exploratec-udd/TornamesaEscaner/README.md

# Manual de usuario para tornamesa de escáner 3D

El Tornamesa de escáner 3D de ExploraTec es una herramienta de licencia abierta de apoyo a la hora de utilizar cualquier tipo de escáner 3d, facilitando el proceso de escanear objetos al rotarlos por el usuario. Se controla a través de una página web alojada en una red local de WiFi

Tornamesa_Render

## Componentes:

### Electrónica:

- #### ESP-32 Dev kit

  El cerebro de la herramienta, utilizado para controlar señales al motor, alojar la página web y crear la red local.

- #### Motor Stepper Bipolar Kysan 1124090 Nema 17

  La fuerza del dispositivo, al ser un Motor Stepper nos permite movimientos controlados y precisos.

- #### Módulo Shield para driver A4988 y driver

  Quien facilita el control de el Motor Stepper, permitirndo además la alimentación del mismo.

- #### Fuente de poder de 9V
  Necesaria pala la alimentación del motor Stepper a través del Modulo Shield

- #### Regulador de voltaje lm2596 dc-dc hw 411 Step Down 

   Quien permite tener una fuente de poder para el dispositivo, al poder usar la fuente de mayor voltaje del motor para poder alimentar a la ESP 32.

 - #### Sensor Hall magnético KY-003

    Para determinar donde se encuentra la rotación del motor y calibración

 |<!-- -->|<!-- -->|
 |:---:|:---:|
 |ESP-32| Motor Stepper|
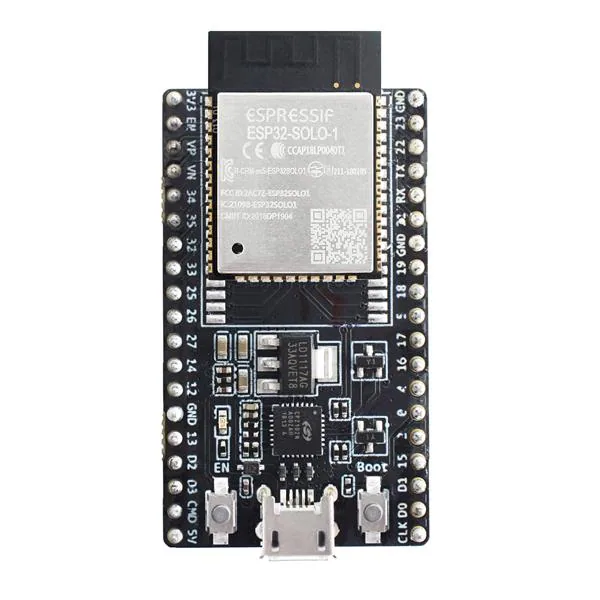
[picture p1: imagenes2/ESP32-DevKit.jpg]
ESP32
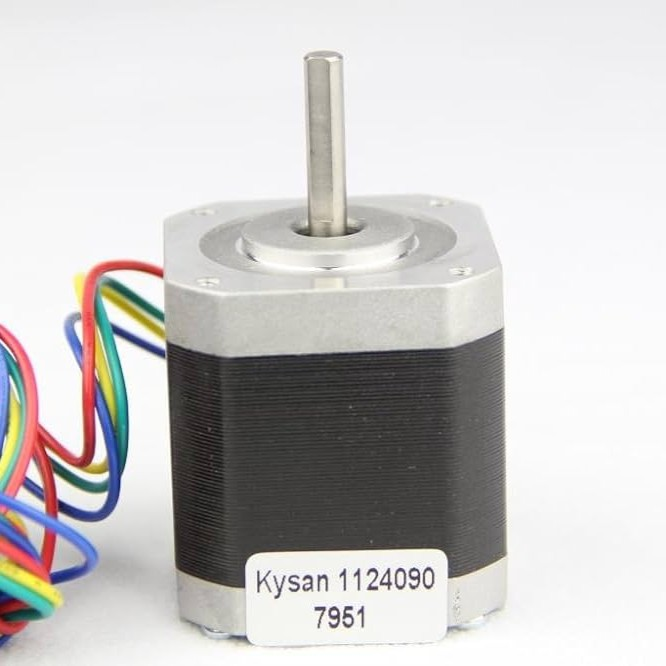
[picture p2: imagenes2/kysan_1124090.jpg]
Kysan 1124090
 |||
 |Módulo Shield|A4988|
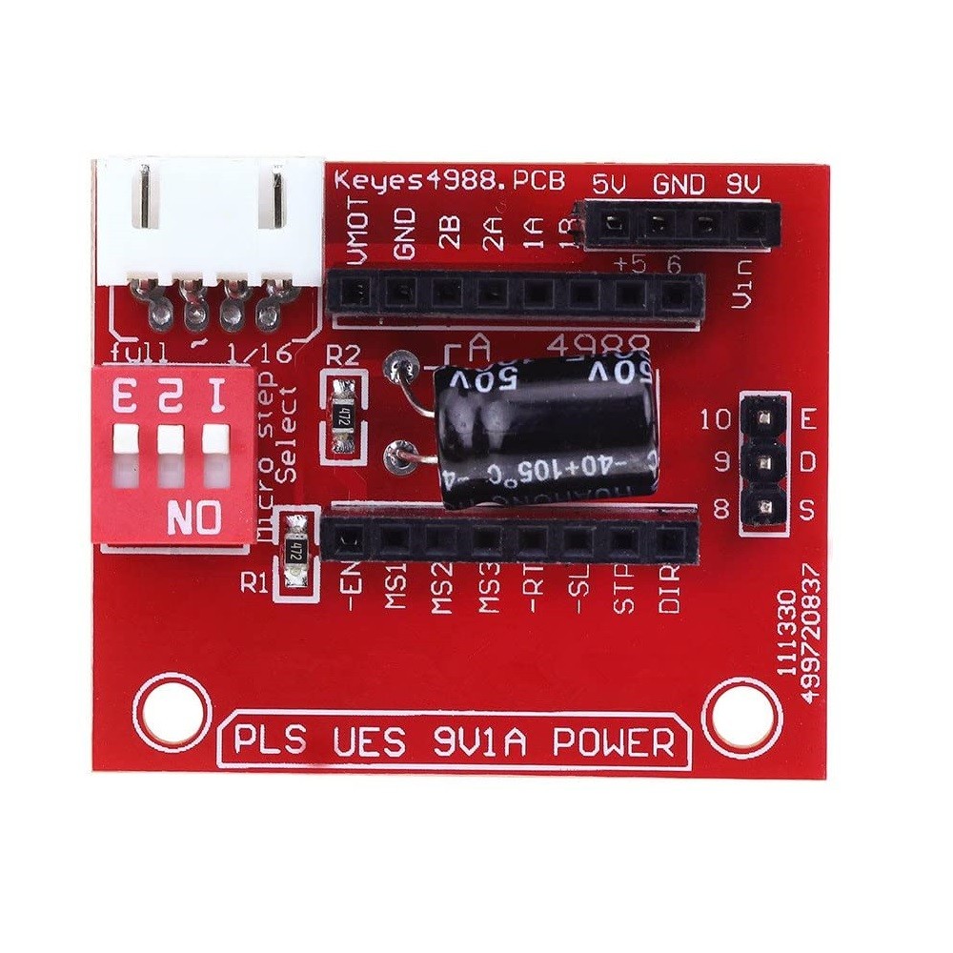
[picture p3: imagenes2/Shield.jpg]
Módulo Shield
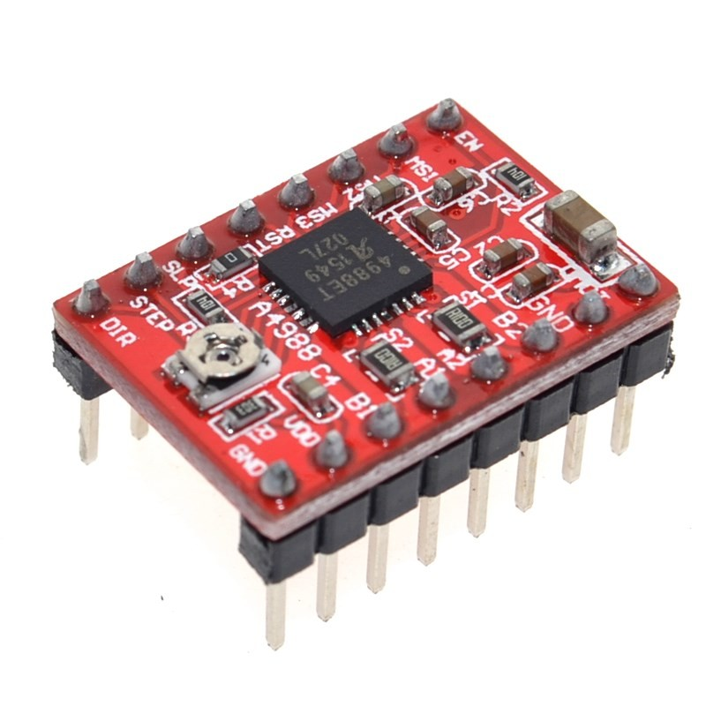
[picture p4: imagenes2/A4988.jpg]
A4988
 |||
 |Fuente de poder|Regulador de voltaje LM2596|
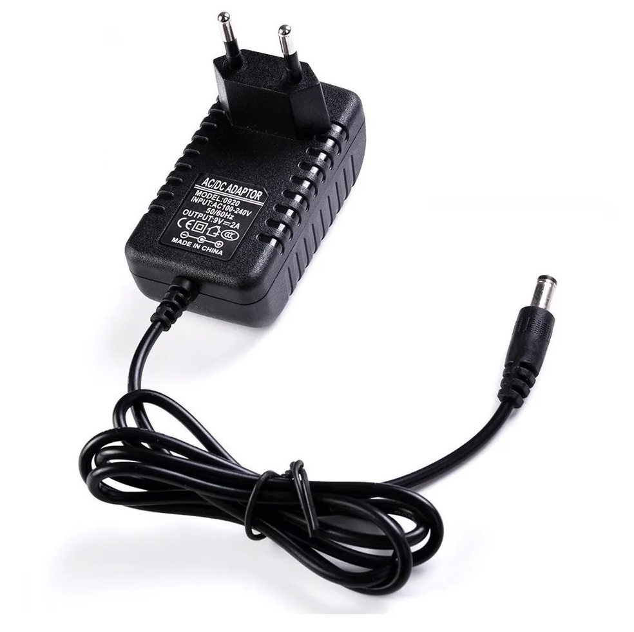
[picture p5: imagenes2/Transformador_de_Corriente.jpg]
Fuente de poder 9V
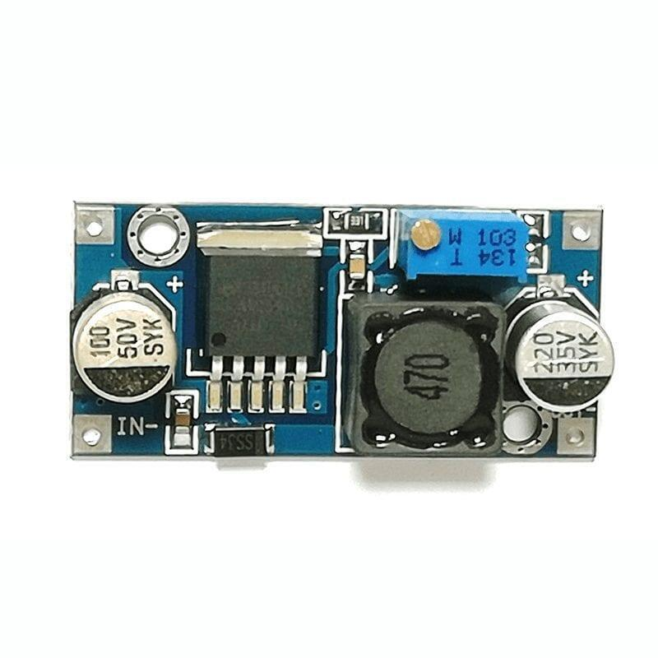
[picture p6: imagenes2/LM2596_Regulador_Step_Down.jpg]
lm2596 dc-dc hw 411 Step Down
 |||
 |Sensor Hall magnético KY-003|
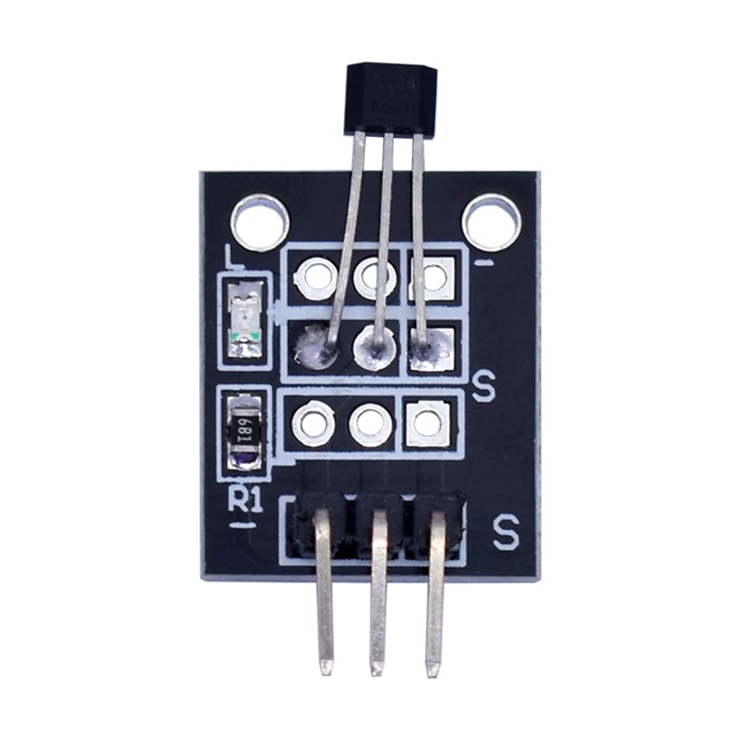
[picture p7: imagenes2/Hall.jpg]
Hall magnético KY-003
 ||
### Hardware:

- #### Componentes Impresos del cuerpo de la mesa

  Las piezas que conforman la estructura de este dispositivo

- #### Pernos e insertos M3

  Encargados de sostener los componentes impresos del Tornamesa

- #### Imán de Neodimio circular 10x3mm

  Necesario para la calibración del dispositivo, es censado por el sensor Hall.  

- #### Rodamiento NSK 6205 C3 ( 25mm x 52mm x 15mm )
  
  Usadas para alivianar el roce y sostener la base de giro

- #### Canicas de 10mm
  
  Usadas para alivianar el roce y equilibrar la superficie de la mesa

- #### Superficie circular (Mínimo 12 Cm)

  Superficie de la mesa donde se colocan los objetos que se deseen escanear, material a elección del usuario.

### Software:

- #### Arduino IDE

  Un entorno de desarrollo integrado que nos permite programar y actualizar el cerebro del sistema.

 - #### Navegador Web

  El dispositivo al ser controlado por una página web local es necesario un navegador para utilizarlo.

 |Arduino IDE|Navegador Web|
 |:---:|:---:|
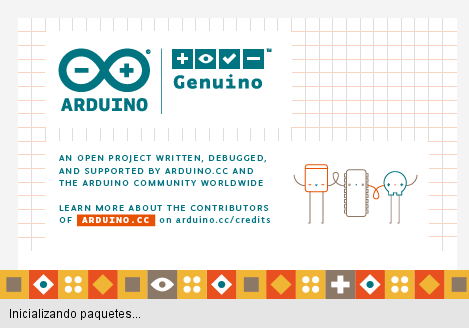
[picture p8: imagenes2/Arduino_IDE.png]
Arduino IDE
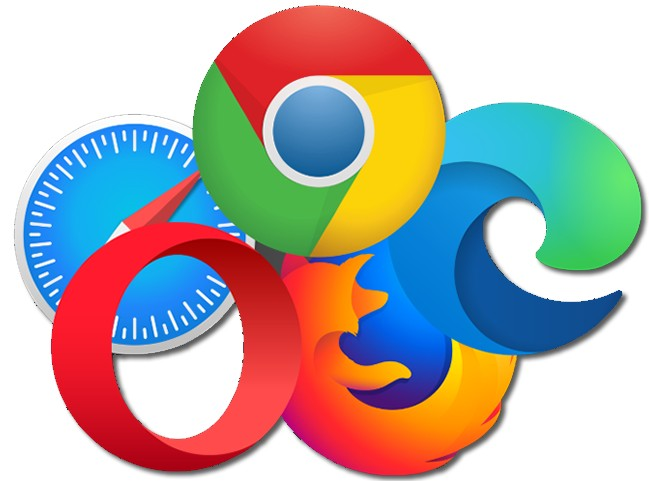
[picture p9: imagenes2/Navegadores.jpg]
Navegadores Web
|||

## Vista explosionada:
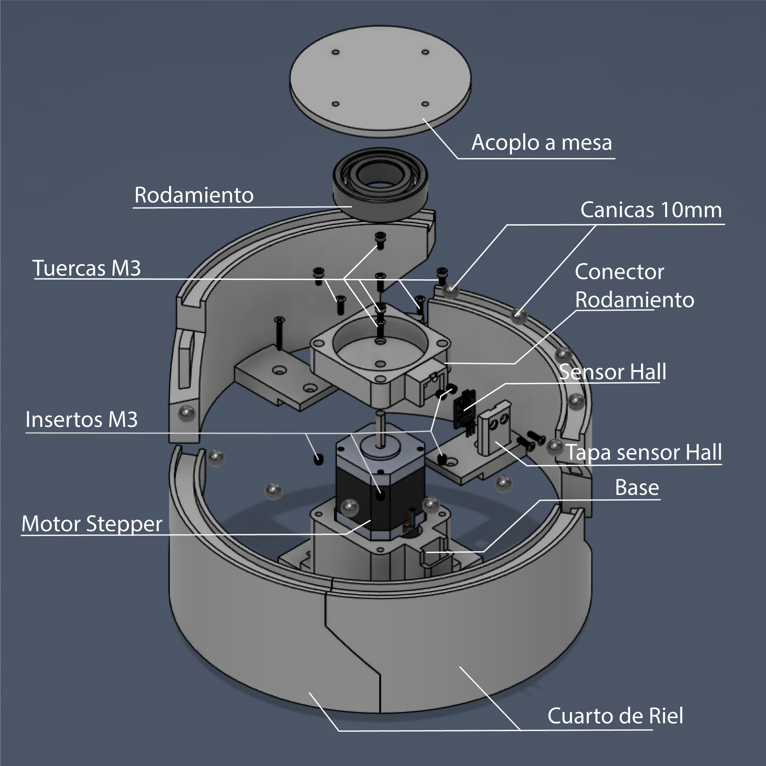
[picture p10: imagenes2/Plano_vista_explosiva.png]
Plano de vista Explosiva del tornamesa


## Instrucciones de uso:

### Encendido

Al encender el dispositivo este como primer paso iniciará su calibración, girará en sentido antihorario para encontrar su punto de inicio:

GifInicio

### Conección y página web

Por defecto, el nombre de la red que debes conectarte para controlar el tornamesa es "ExploraTec Plataforma de Escaner" la cual es una red que permite **hasta 1 usuario por sesion**. La contraseña por defecto es **"12345678"** para acceder a esta y si es accedida a través del telefono celular es posible que pregunte si deseas mantenerte en la red debido a que, al ser una red local, no posee conección al internet.
|<!-- -->|<!-- -->|
|:---:|:---:|
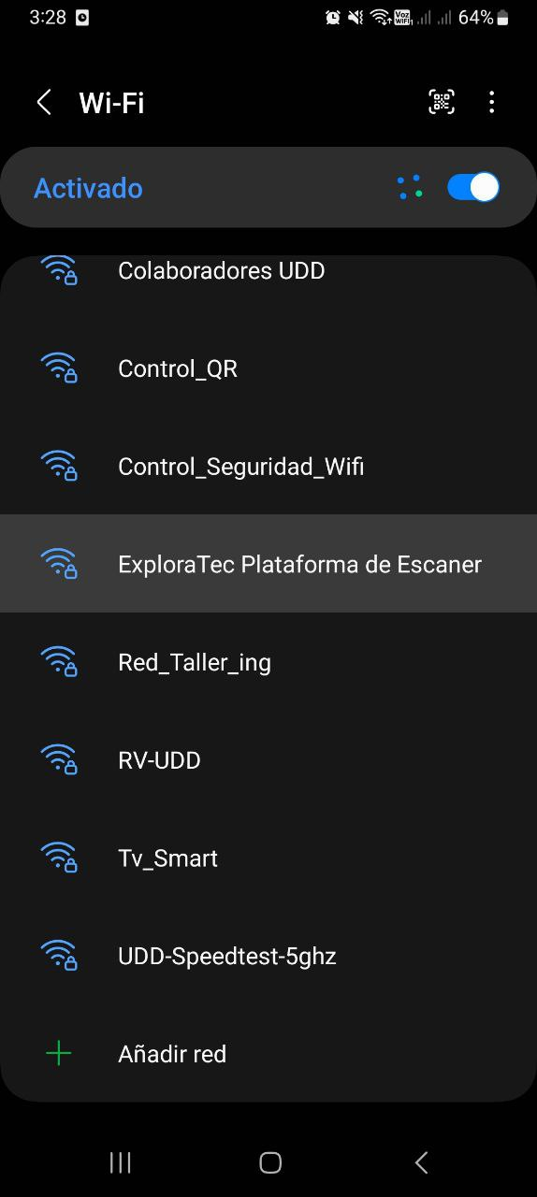
[picture p11: imagenes2/Coneccion_1.jpg]
Red
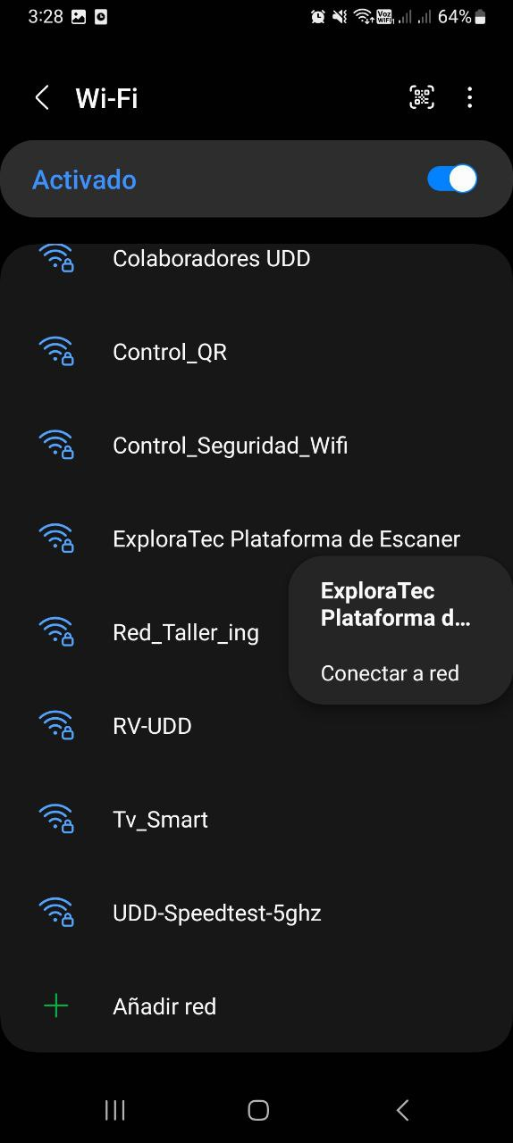
[picture p12: imagenes2/Coneccion_2.jpg]
Coneccion
|||
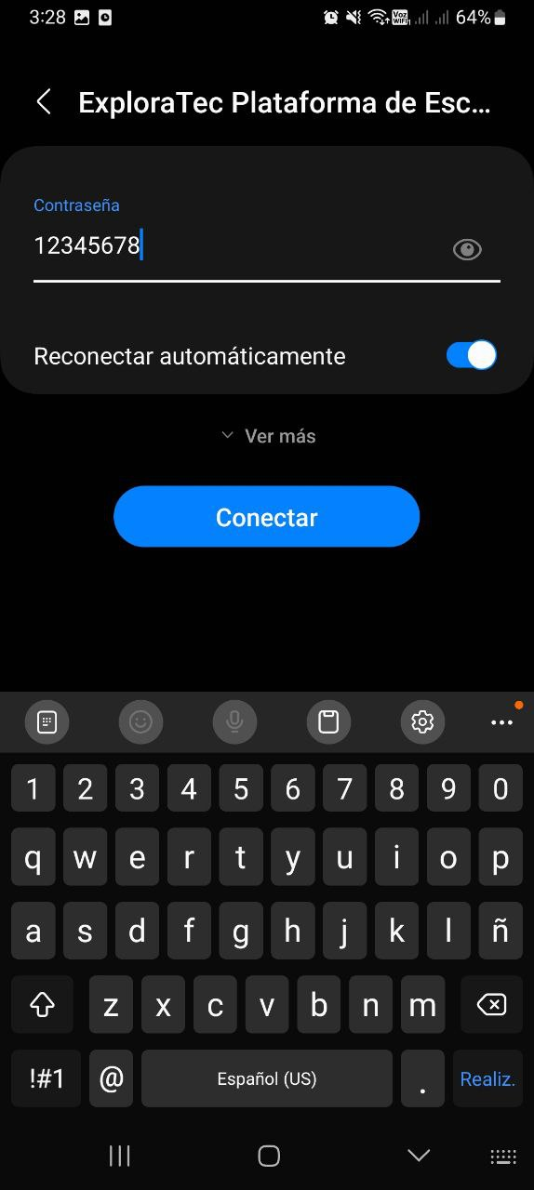
[picture p13: imagenes2/Coneccion_3.jpg]
Clave
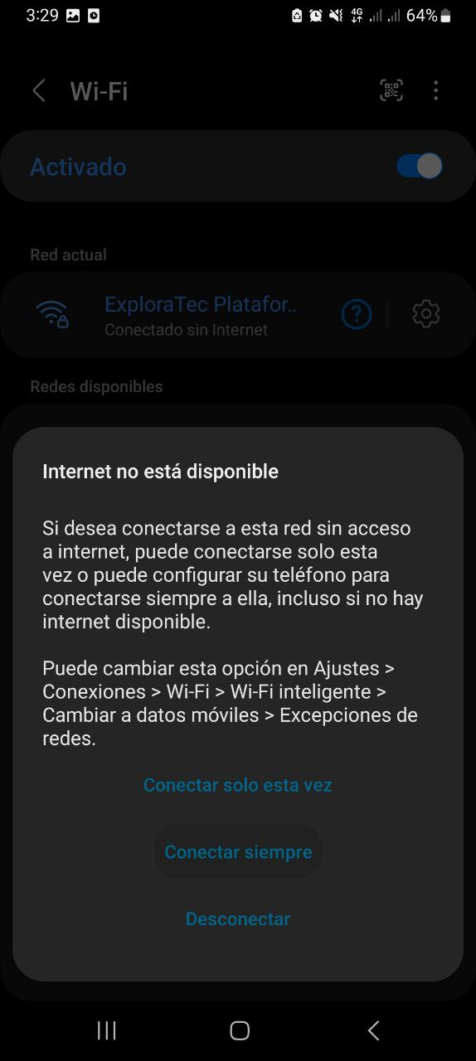
[picture p14: imagenes2/Coneccion_4.jpg]
Aceptar
|||

Al estar dentro de la red local debes entrar a tu navegador y entrar a la página web de control. Por defecto el link de esta es el 192.168.4.1. Si no puedes entrar a esta, es posible que tu dispositivo te haya conectado a otra red en busca de una red coon internet.

|<!-- -->|<!-- -->|
|:---:|:---:|
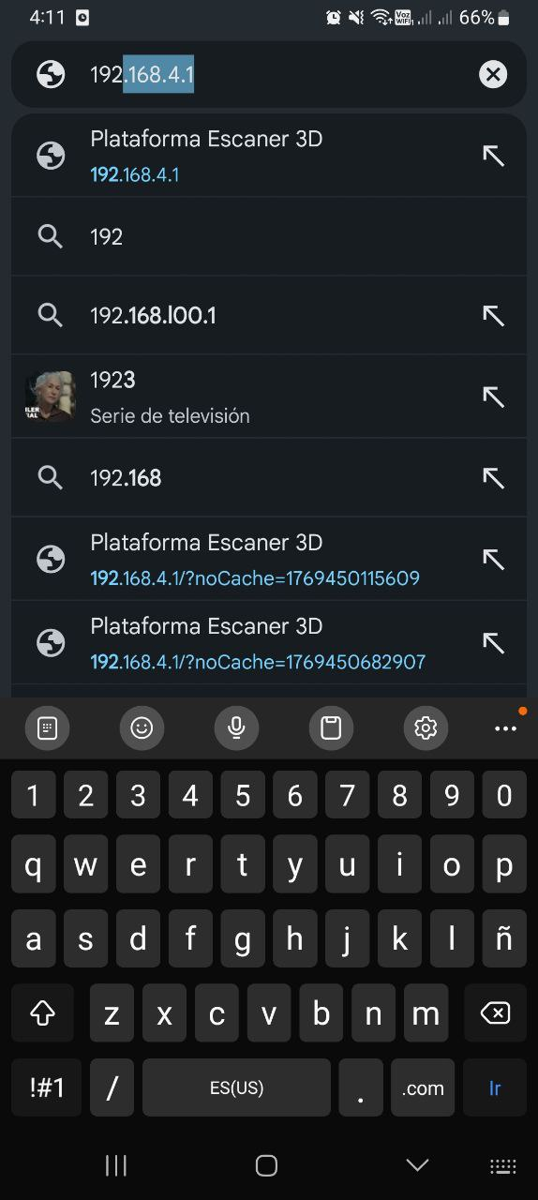
[picture p15: imagenes2/Pagina_1.jpg]
URL
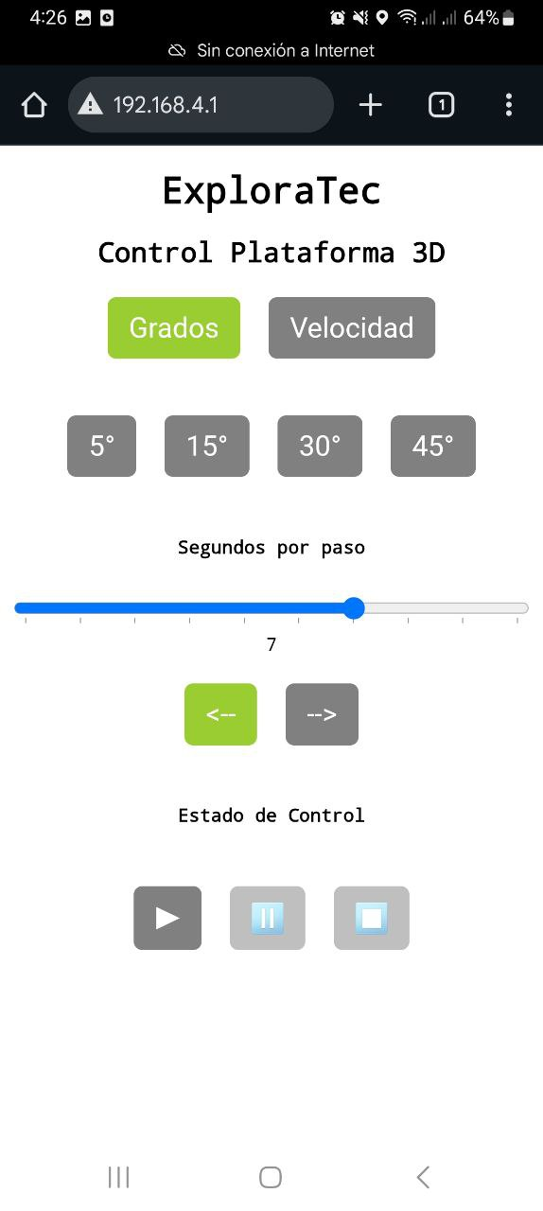
[picture p16: imagenes2/Pagina_2.jpg]
página
|||

### Control del dispositivo

El Tornamesa de escaner 3D tiene 2 modos, los cuales son **giro por grados** y **giro por velocidad**, los cuales pueden ser seleccionados en el inicio de la página como los primeros botones. 

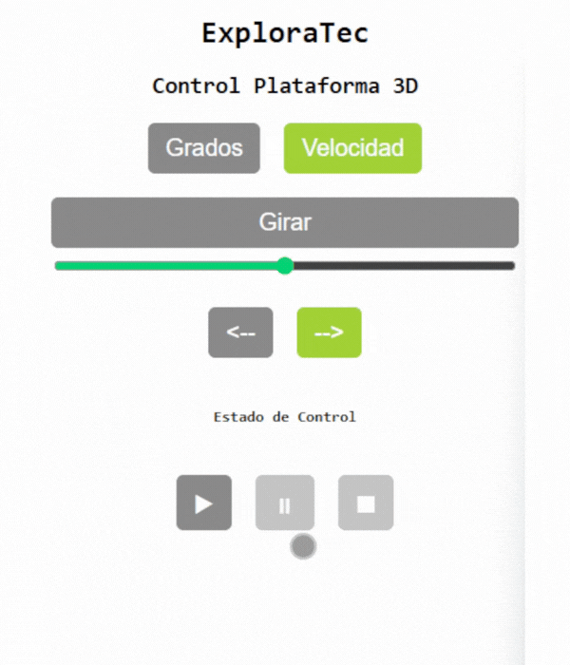
[picture p17: imagenes2/Modos.gif]
Modos
  

En el primer modo, la plataforma del tornamesa girará una revolución completa, avanzando una cantidad de grados determinada por el usuario, en intervalos de tiempo tambén seleccionados por el mismo. En cambio, en el segundo modo la plataforma girará indefinidamente a una velocidad designada por el usuario. Ha de mencionar que ningúna de las acciones mencionadas ocurrirá a ecepción de que el boton de inicio haya sido presionado.

Tornamesa girando con zapatilla impresa en 3d

Tras ser precionado el boton de inicio, todas las configuraciones (a ecepción de dirección, velocidad y giro en el modo de velocidad) serán bloqueadas y no se podrán utilizar hasta que el proceso termine o sea cancelado con el boton de parar. Todos los comandos asignados al apretar el boton de inicio pueden ser pausados con el boton de pausa.

|Modo Grados|Modo Velocidad|
|:---:|:---:|
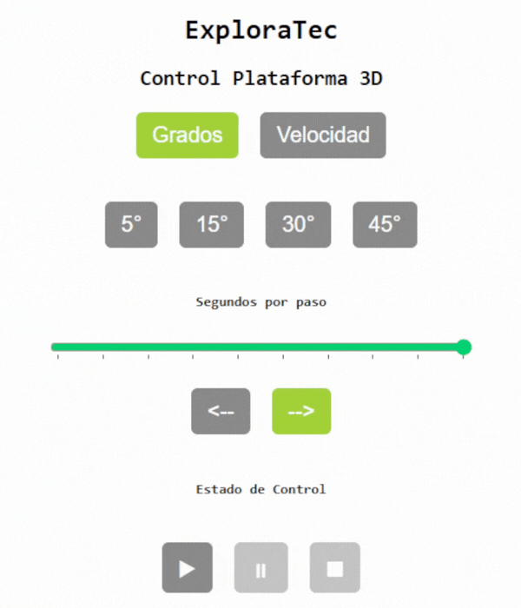
[picture p18: imagenes2/Modo grados.gif]
Modo Grados
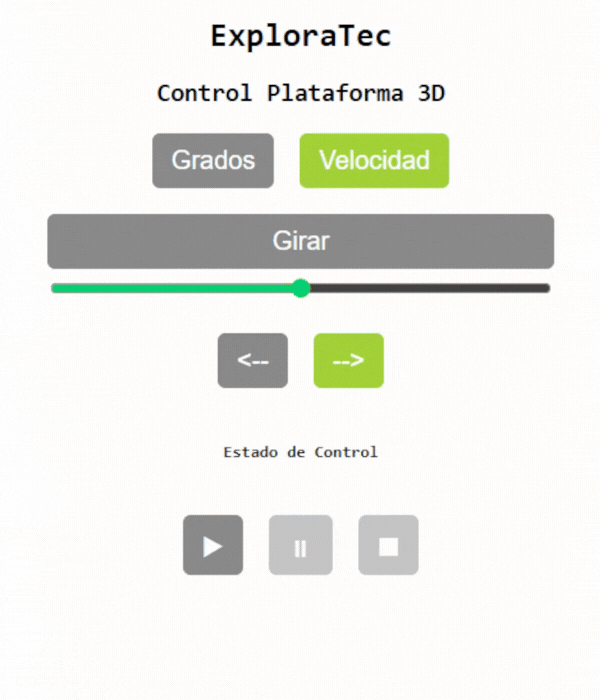
[picture p19: imagenes2/Modo Giro.gif]
Modo Giro
|||

>documentado por [Sofía Pérez Gutiérrez](https://github.com/ItsPeku) 2026
