exploratec-udd/TornamesaEscaner/imagenes2/Navegador.jpg

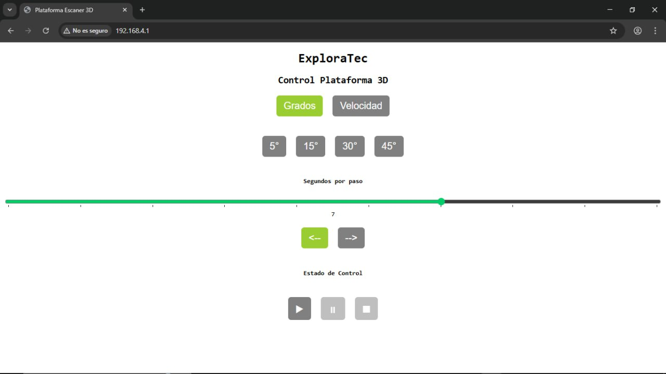
imagenes2/Navegador.jpg
