exploratec-udd/TornamesaEscaner/imagenes2/Tornamesa_Escaner_Render.png

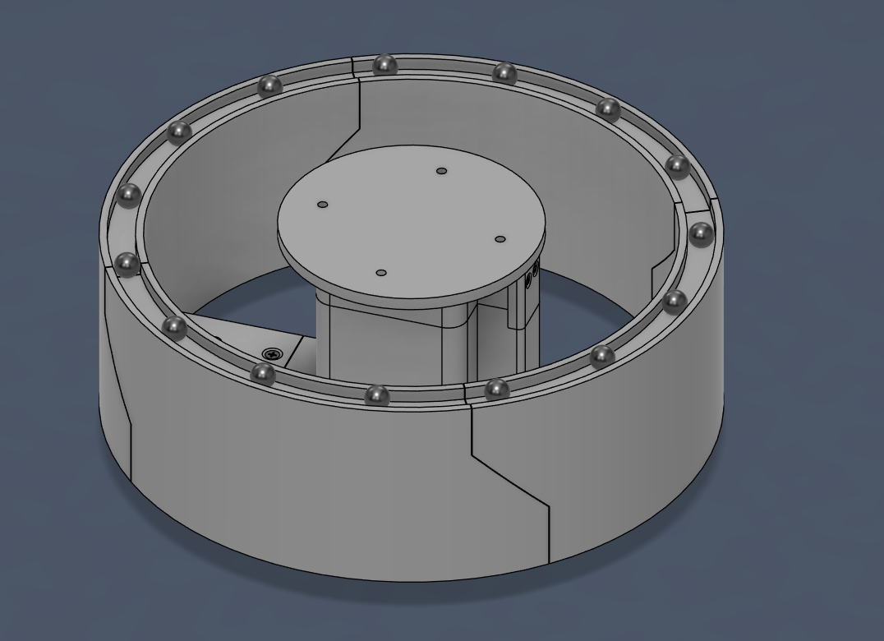
imagenes2/Tornamesa_Escaner_Render.png
