exploratec-udd/TornamesaEscaner/Piezas de Tornamesa para Escaner 3D/Tornamesa Escaner - Base.step

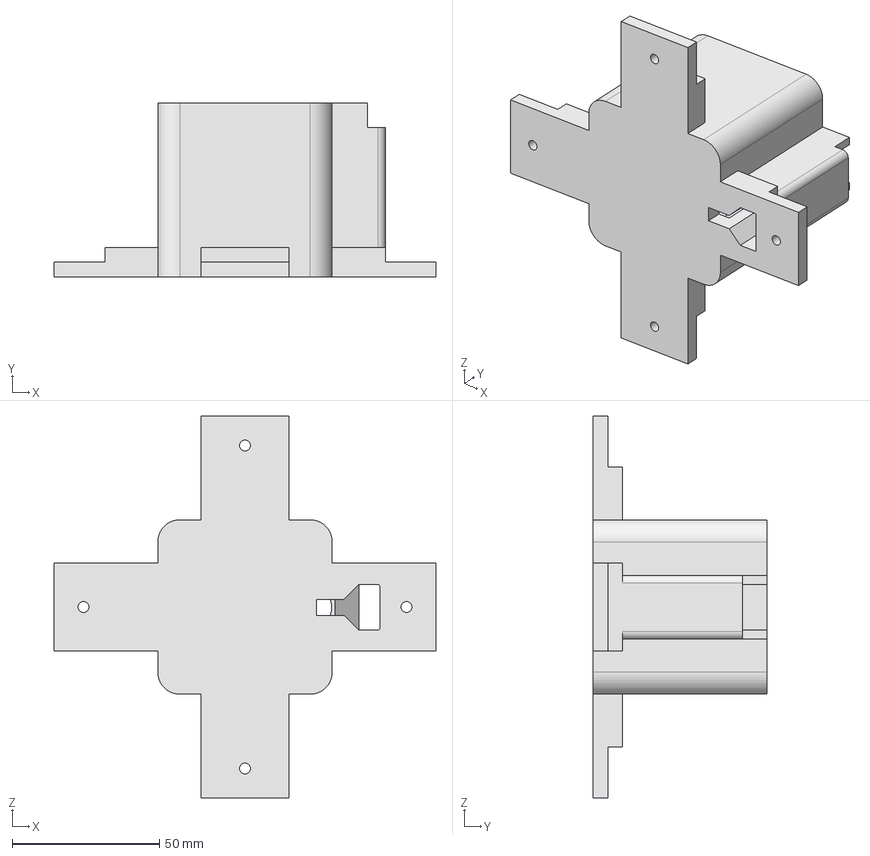
[picture p22: CAD file, 2026-01-28]
Piezas de Tornamesa para Escaner 3D/Tornamesa Escaner - Base.step
129.6 x 59.0 x 129.6 mm
