exploratec-udd/TornamesaEscaner/Piezas de Tornamesa para Escaner 3D/Tornamesa Escaner - Cuarto de riel.step

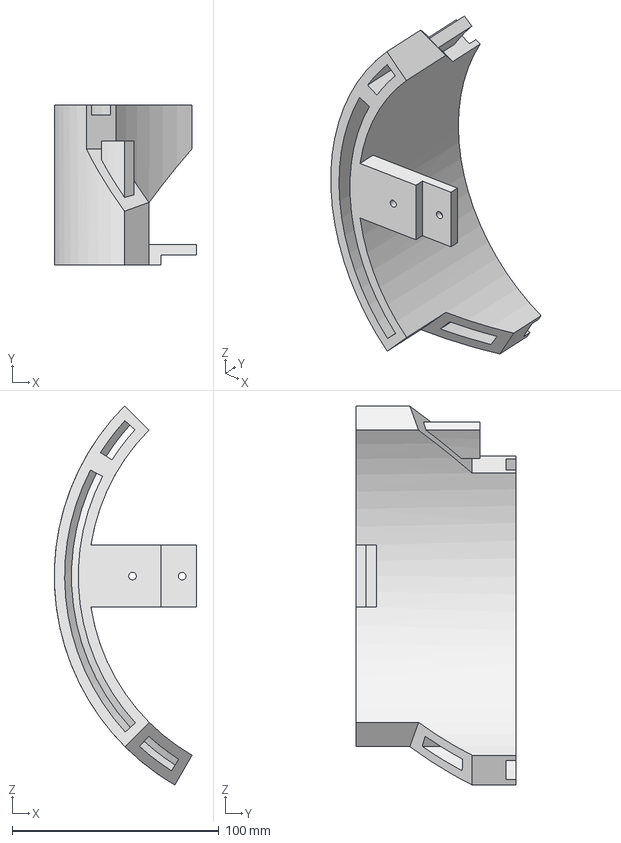
[picture p23: CAD file, 2026-01-28]
Piezas de Tornamesa para Escaner 3D/Tornamesa Escaner - Cuarto de riel.step
68.8 x 77.5 x 183.2 mm
