exploratec-udd/TornamesaEscaner/Piezas de Tornamesa para Escaner 3D/Tornamesa Escaner - Conector Rodamiento y Hall_.step

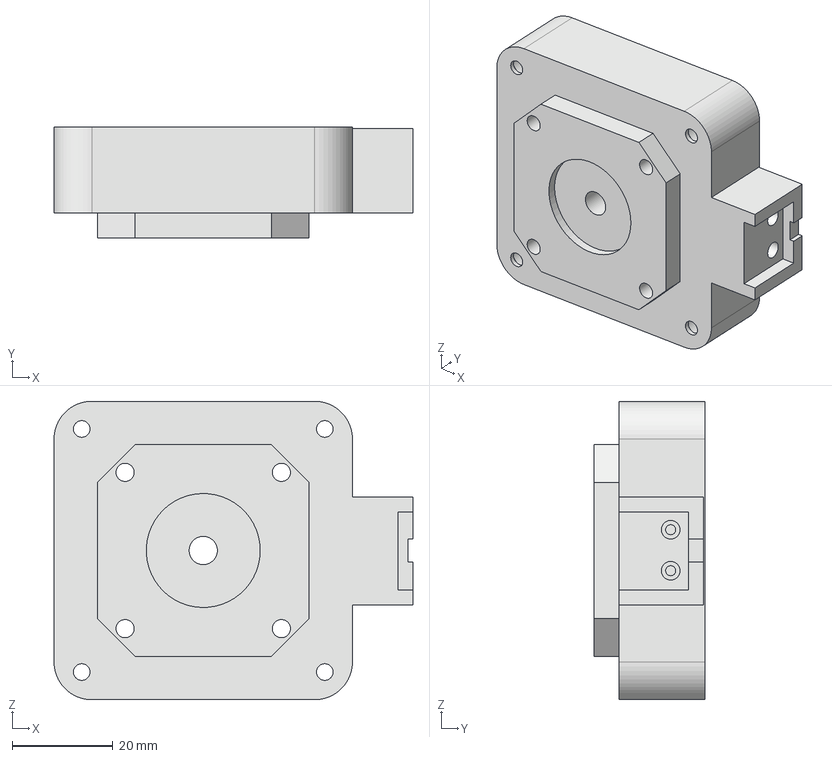
[picture p24: CAD file, 2026-01-28]
Piezas de Tornamesa para Escaner 3D/Tornamesa Escaner - Conector Rodamiento y Hall_.step
71.2 x 22.0 x 59.2 mm
