exploratec-udd/TornamesaEscaner/Piezas de Tornamesa para Escaner 3D/Tornamesa Escaner - Tapa sensor Hall.step

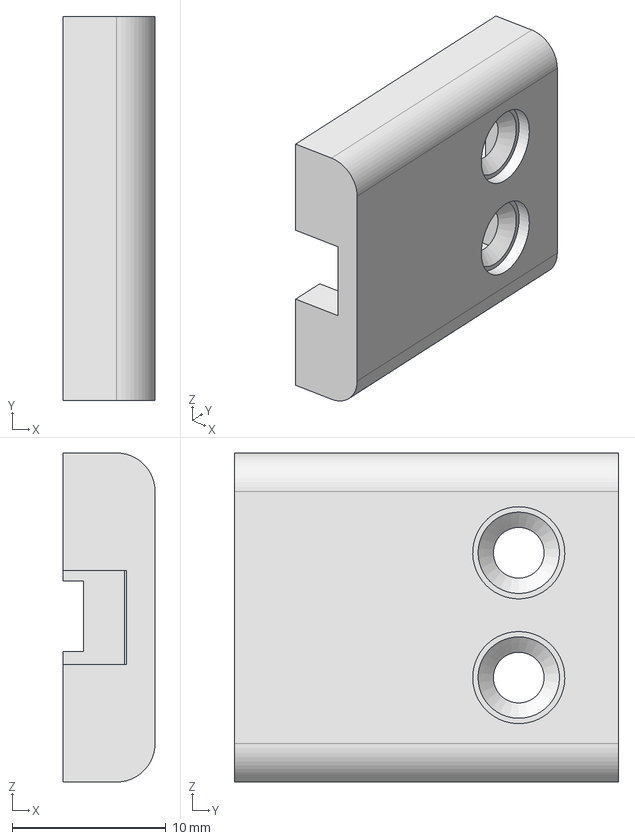
[picture p25: CAD file, 2026-01-28]
Piezas de Tornamesa para Escaner 3D/Tornamesa Escaner - Tapa sensor Hall.step
6.00 x 25.0 x 21.4 mm
