exploratec-udd/TornamesaEscaner/Piezas de Tornamesa para Escaner 3D/Tornamesa Escaner - Acoplo mesa.step

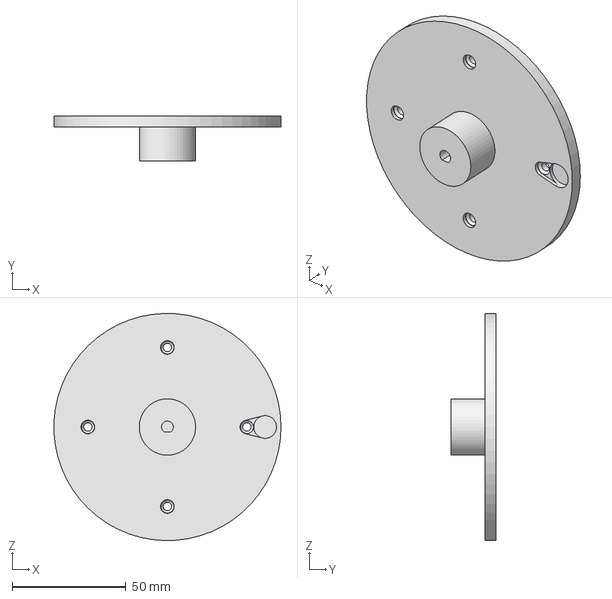
[picture p26: CAD file, 2026-01-28]
Piezas de Tornamesa para Escaner 3D/Tornamesa Escaner - Acoplo mesa.step
99.9 x 20.0 x 100.0 mm
