exploratec-udd/TornamesaEscaner/(commit log)

2026-01-27 Update README.md
    Entrada 1: componentes 👍
2026-01-27 Update README.md
    Agregando estructura en el área de componentes y en las instrucciones de uso
2026-01-28 Agregando archivos del proyecto
    El codigo para la ESP32, el HTML y los archivos de impresión
    [Tornamesa Escaner - Acoplo mesa.step, Tornamesa Escaner - Base.step, Tornamesa Escaner - Conector Rodamiento y Hall_.step, Tornamesa Escaner - Cuarto de riel.step, Tornamesa Escaner - Tapa sensor Hall.step]
2026-01-28 Cambiando Imágenes que tenían errores
2026-01-28 Actualización de codigo
    Error en el nombre de red
    [Tornamesa Escaner - ESP32.ino]
2026-02-24 Update README.md
    Imagen de sensor Hall reparafa
